amsimer/Weightlifting-project/Hardware/Final Hardware Setup.jpeg

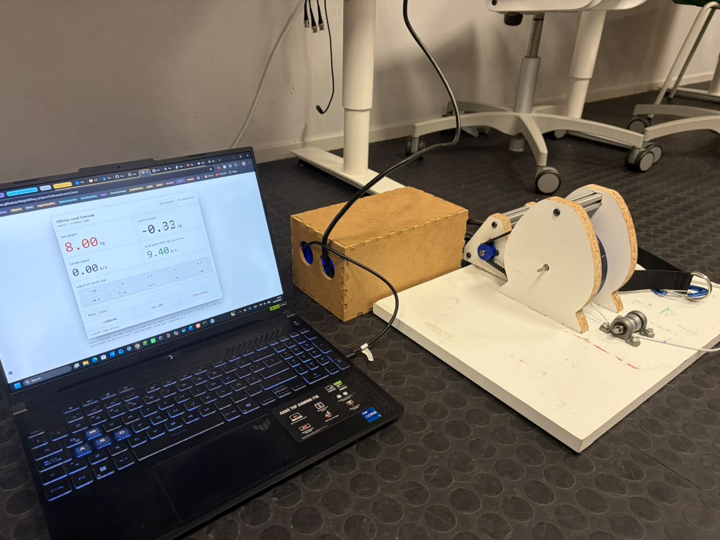
Hardware/Final Hardware Setup.jpeg
