amsimer/Weightlifting-project/Software/Demos/README.md

# Interface demos

These screen recordings show the two wireless interfaces during a training session.

- [iOS application demo](ios-app-recording.mp4) — Bluetooth Low Energy control and live training feedback
- [Wi-Fi dashboard demo](web-dashboard-recording.mov) — browser-based control and live training feedback

The recordings focus on the software interfaces. Physical training videos containing identifiable people are not included in this public repository.
