amsimer/Weightlifting-project/DataValidation.xlsx

POWERCABLE V2 - Speed Validation
The adapive resistance mode works based on the user's speed, lowering the weight if the user is unable to the rep at their desired workout speed. To validate if the program is calculating the speed correctly, we used the video tracking software, Tracker, to calculate the speed of several reps and compare this with the value displayed by the interface.
Tracker data
t | x (m) | y (m) | v (m/s)
 | mass_A
t | x | y | vx | vy | v
0 | 0.5517678 | 0.04902069
0.03333333 | 0.5518622 | 0.05318799 | 0.002980265 | 0.1078582 | 0.1078993665
0.06666667 | 0.5519664 | 0.05621123 | 0.008024896 | 0.06840488 | 0.06887399047
0.1 | 0.5523972 | 0.05774831 | 0.003078589 | 0.01552269 | 0.01582503128
0.1333333 | 0.5521717 | 0.05724608 | -0.002528793 | -0.03373725 | 0.03383189075
0.1666667 | 0.5522286 | 0.05549916 | 0.01333763 | -0.04451308 | 0.04646834046
0.2 | 0.5530608 | 0.05427854 | 0.03055455 | -0.02270968 | 0.03806980551
0.2333333 | 0.5542655 | 0.05398518 | 0.0321607 | 0.01174878 | 0.034239516 | Data Validation
0.2666667 | 0.5552049 | 0.05506179 | 0.02171767 | 0.03711422 | 0.04300142459 | rep | Interface speed (m/s) | Tracker Speed (m/s) | Error
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
