amsimer/Weightlifting-project/problem-lean-canvas (2) (1).pdf

# Problem

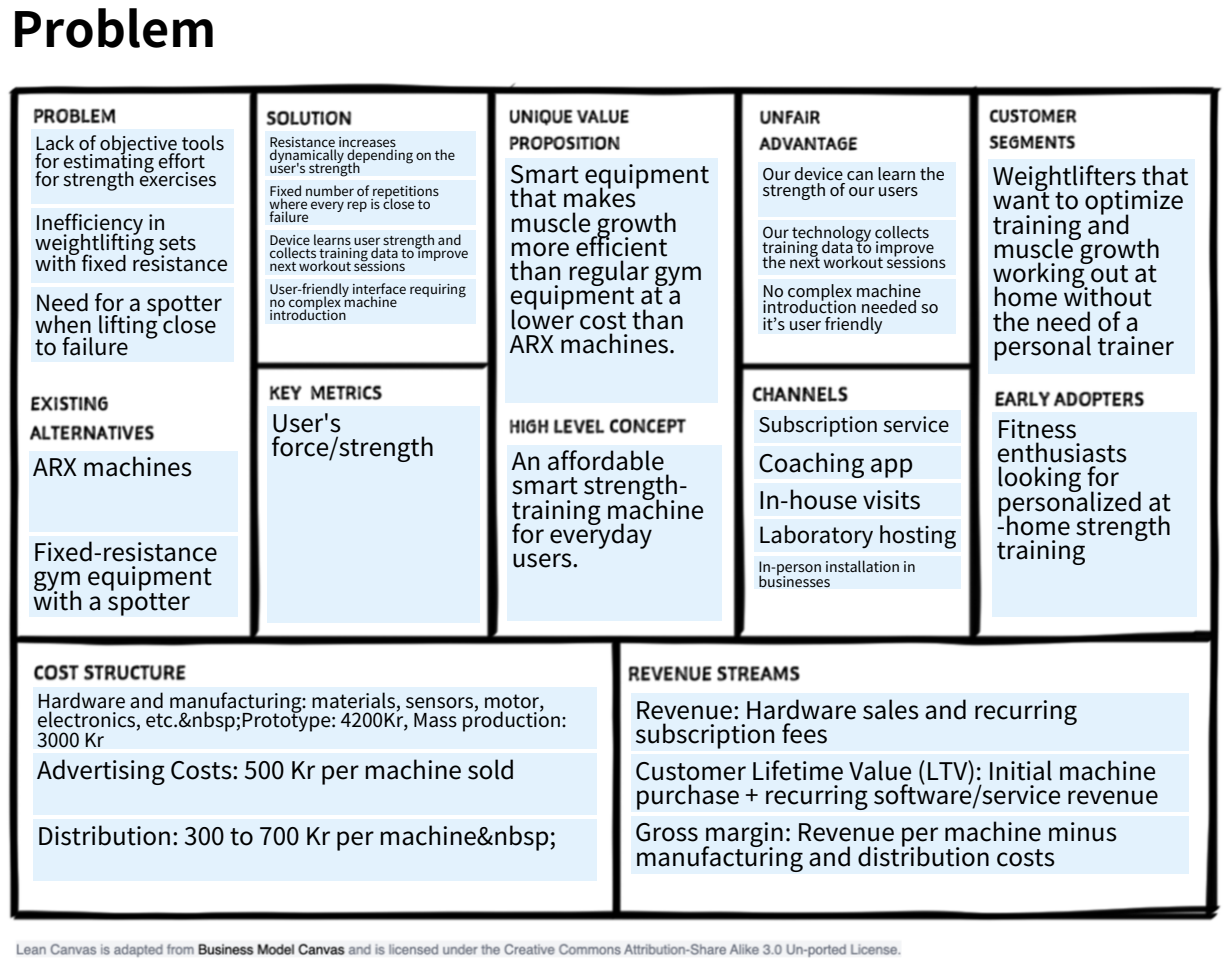
[picture p22: page 1]

Lack of objective tools
for estimating effort
for strength exercises

Inefficiency in
weightlifting sets
with fixed resistance
Need for a spotter
when lifting close
to failure

ARX machines

Fixed-resistance
gym equipment
with a spotter

Resistance increases
dynamically depending on the user's strength
Fixed number of repetitions where every rep is close to failure
Device learns user strength and collects training data to improve next workout sessions
User-friendly interface requiring no complex machine
introduction

User's
force/strength

Smart equipment
that makes
muscle growth
more efficient
than regular gym
equipment at a
lower cost than
ARX machines.

An affordable
smart strength-training machine
for everyday
users.

Our device can learn the
strength of our users

Our technology collects
training data to improve
the next workout sessions

No complex machine
introduction needed so
it’s user friendly

Subscription service
Coaching app
In-house visits
Laboratory hosting

In-person installation in
businesses

Weightlifters that
want to optimize
training and
muscle growth
working out at
home without
the need of a
personal trainer

Fitness
enthusiasts
looking for
personalized at
-home strength
training

Hardware and manufacturing: materials, sensors, motor, electronics, etc.&nbsp;Prototype: 4200Kr, Mass production: 3000 Kr
Advertising Costs: 500 Kr per machine sold

Distribution: 300 to 700 Kr per machine&nbsp;

Revenue: Hardware sales and recurring subscription fees
Customer Lifetime Value (LTV): Initial machine purchase + recurring software/service revenue Gross margin: Revenue per machine minus manufacturing and distribution costs
