amsimer/Weightlifting-project/Hardware/PCB/pcb.kicad_pcb

## KiCad design Hardware/PCB/pcb.kicad_pcb (2026-10-20)

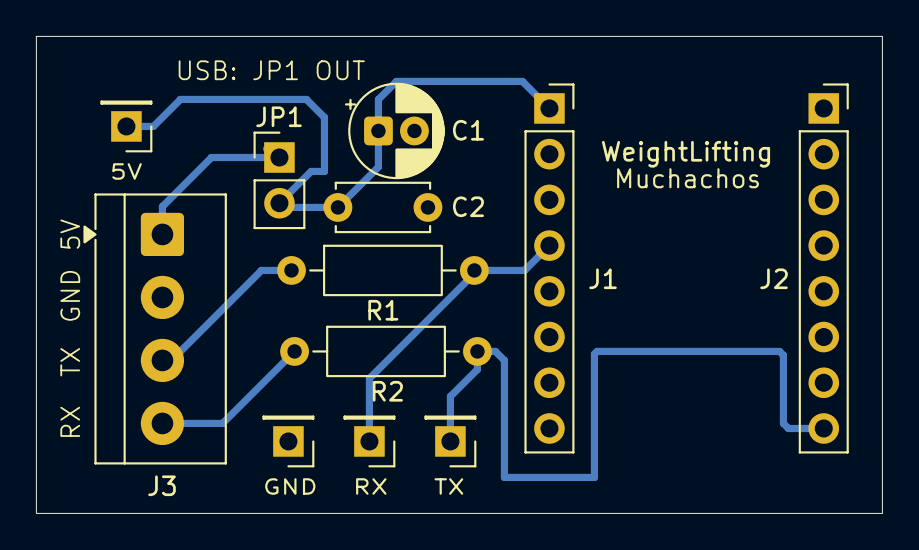
[picture p23: board pcb.kicad_pcb from above]

Board: 2 copper layers, 47.0 x 26.5 mm, 12 parts (0 on the bottom side), 7 nets.

Parts:
C1: 100u; CP_Radial_D5.0mm_P2.00mm
C2: 100n; C_Disc_D5.0mm_W2.5mm_P5.00mm
J1: ESP_LEFT_ROW; PinSocket_1x08_P2.54mm_Vertical
J2: ESP_RIGHT_ROW; PinSocket_1x08_P2.54mm_Vertical
J3: ODRIVE; TerminalBlock_4Ucon_1x04_P3.50mm_Horizontal
JP1: ODRIVE_POWER_ENABLE; PinHeader_1x02_P2.54mm_Vertical
R1, R2: 4.7k; R_Axial_DIN0207_L6.3mm_D2.5mm_P10.16mm_Horizontal
TP1: ESP_5V; PinHeader_1x01_P2.54mm_Vertical
TP2: GND; PinHeader_1x01_P2.54mm_Vertical
TP3: ESP_RX_GPIO4; PinHeader_1x01_P2.54mm_Vertical
TP4: ESP_TX_GPIO21; PinHeader_1x01_P2.54mm_Vertical

Connections:
/ESP_5V: C1.1, C2.2, J1.1, JP1.2 (B), TP1.1 (1_1)
/ESP_RX_GPIO4: J1.4, R1.2, TP3.1 (1_1)
/ESP_TX_GPIO21: J2.8 (Pin_8_8), R2.2, TP4.1 (1_1)
/ODRIVE_5V: J3.1, JP1.1 (A)
/ODRIVE_RX: J3.4, R2.1
/ODRIVE_TX: J3.3, R1.1
GND: C1.2, C2.1, J1.2, J3.2, TP2.1 (1_1)
