amsimer/Weightlifting-project/(commit log)

2026-09-09 Add calibration and current limit commands
2026-09-09 Weightmachine_V2
    Changes to make the device work:
    self.motor.axis1.clear_errors() -----> self.motor.clear_errors()
    axis0 -----> axis1
2026-09-19 Implement Kivy app for ODrive motor control
    This code implements a Kivy application for controlling an ODrive motor. It includes a user interface for setting and displaying weights, as well as buttons for calibration and error handling.
    [pythonworkingcode_mac.py]
2026-10-03 Update control.html
    Made the connection more reliable, it can be done without specific steps, the calibration can be done all the time.
2026-10-09 Update control.html
    Control Interface with added adaptive resistance setting
2026-10-15 Add files via upload
    .svg file of the cable box designed in boxes .py
2026-10-19 Update README with hardware improvements and design details
    Added details about hardware improvements and cable box design.
2026-10-20 Add ESP32 firmware, iOS app, and Wi-Fi dashboard
    Add the current wireless interfaces and shared ESP32 motor-control firmware. Document both communication paths and ignore generated macOS/Xcode user files.
2026-10-20 Improve software documentation and links
    Integrate the iOS app, Wi-Fi dashboard, and ESP32 firmware descriptions into the main Software section and add direct source links.
2026-10-20 Add PCB design files and dashboard link
